Bytewerk/feuchtwerk/export/v1.0/feuchtwerk.jpg

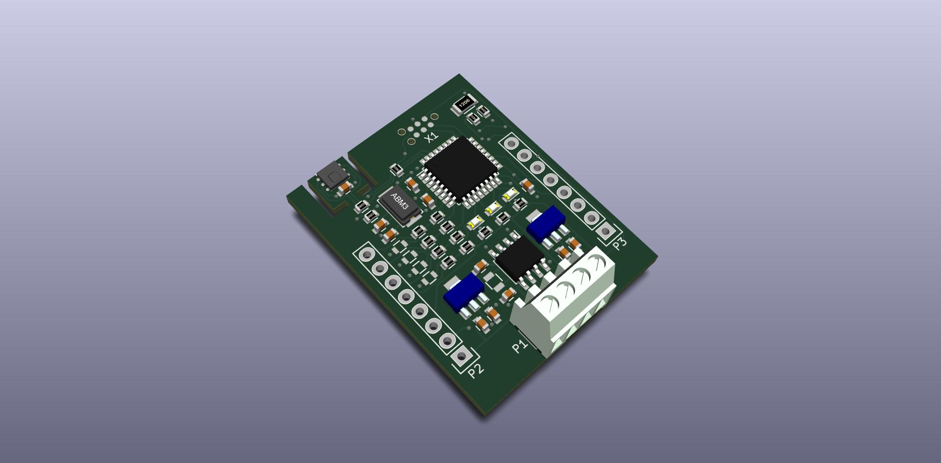
export/v1.0/feuchtwerk.jpg
