Bytewerk/feuchtwerk/export/v1.0/bom.xls

Id | Designator | Package | Qty | Designation | Spec | Manufacturer | MPN | Link
1 | C1,C4,C5,C6,C9,C12 | C_0603 | 6 | 100nF | MLCC/0.1uF/10V | Murata | GRM188R71E104KA01D | http://www.mouser.de/ProductDetail/Murata-Electronics/GRM188R71E104KA01D
2 | C2,C3 | C_0603 | 2 | 18pF | MLCC/18pF/10V | Vishay | VJ0603A180FXACW1BC | http://www.mouser.de/ProductDetail/Vishay-Vitramon/VJ0603A180FXACW1BC
3 | C7,C8,C10,C11 | C_0603 | 4 | 1uF | MLCC/1uF/25V | Murata | GRM188R61E105KA12D | http://www.mouser.de/ProductDetail/Murata-Electronics/GRM188R61E105KA12D
4 | D1 | LED_0603 | 3 | LED | red, any | Kingbright | APT1608EC | http://www.mouser.de/ProductDetail/Kingbright/APT1608EC
5 | D2 | LED_0603 | 3 | LED | yellow, any | Kingbright | APT1608YC | http://www.mouser.de/ProductDetail/Kingbright/APT1608YC
6 | D3 | LED_0603 | 3 | LED | green, any | Kingbright | APT1608SGC | http://www.mouser.de/ProductDetail/Kingbright/APT1608SGC
7 | P1 | Pin_Header_Straight_1x04 | 1 | CONN_01X04 | exact | TE Connectivity | 1546215-4 | http://www.mouser.de/ProductDetail/TE-Connectivity/1546215-4
8 | P2,P3 | Pin_Header_Straight_1x08 | 2 | CONN_01X08 | any | Würth Electronics | 61300811121 | http://www.mouser.de/ProductDetail/Wurth-Electronics/61300811121
9 | R1 | R_1206 | 1 | SFH3710 | exact | Osram | SFH 3710-3/4-Z | http://www.mouser.de/ProductDetail/OSRAM-Opto-Semiconductors/SFH-3710-3-4-Z
10 | R7,R10,R13,R18 | R_0603 | 4 | 100R | 100R/5% | Yageo | RC0603FR-07100RL | http://www.mouser.de/ProductDetail/Yageo/RC0603FR-07100RL
11 | R20,R21,R22 | R_0603 | 3 | 1K | 1K/5% | Yageo | RC0603FR-071KL | http://www.mouser.de/ProductDetail/Yageo/RC0603FR-071KL
12 | R14,R17 | R_0603 | 2 | 4K7 | 4K7/5% | Yageo | RC0603FR-074K7L | http://www.mouser.de/ProductDetail/Yageo/RC0603FR-074K7L
13 | R2,R5,R8,R11,R15 | R_0603 | 5 | 10K | 10K/5% | Yageo | RC0603FR-0710KL | http://www.mouser.de/ProductDetail/Yageo/RC0603FR-0710KL
14 | R3,R4 | R_0603 | 2 | 220K | 220K/1% | Yageo | RC0603FR-07220KL | http://www.mouser.de/ProductDetail/Yageo/RC0603FR-07220KL
15 | U1 | LQFP-32_7x7mm_Pitch0.8mm | 1 | STM32F042K6Tx | exact | STMicroelectronics | STM32F042K6T7 | http://www.mouser.de/ProductDetail/STMicroelectronics/STM32F042K6T7
16 | U2 | S-PWSON-N6 | 1 | HDC1080 | exact | TI | HDC1080DMBT | http://www.mouser.de/ProductDetail/Texas-Instruments/HDC1080DMBT
17 | U3 | SOT89-3_Housing | 1 | MCP1754ST-3302E/MB | exact | Microchip | MCP1754ST-3302E/MB | http://www.mouser.de/ProductDetail/Microchip/MCP1754ST-3302E-MB
18 | U4 | SOT89-3_Housing | 1 | MCP1754ST-5002E/MB | exact | Microchip | MCP1754ST-5002E/MB | http://www.mouser.de/ProductDetail/Microchip/MCP1754ST-5002E-MB
19 | U5 | SOIC-8_3.9x4.9mm_Pitch1.27mm | 1 | TJA1051/3 | exact | NXP | TJA1051T/3/1J | http://www.mouser.de/ProductDetail/NXP/TJA1051T-3-1J
20 | Y1 | ABM3 | 1 | 8MHz | exact | ABRACON | ABM3-8.000MHz-D2Y-T | http://www.mouser.de/ProductDetail/ABRACON/ABM3-8000MHz-D2Y-T
