Bytewerk/feuchtwerk/export/v1.0/feuchtwerk_schematic.pdf

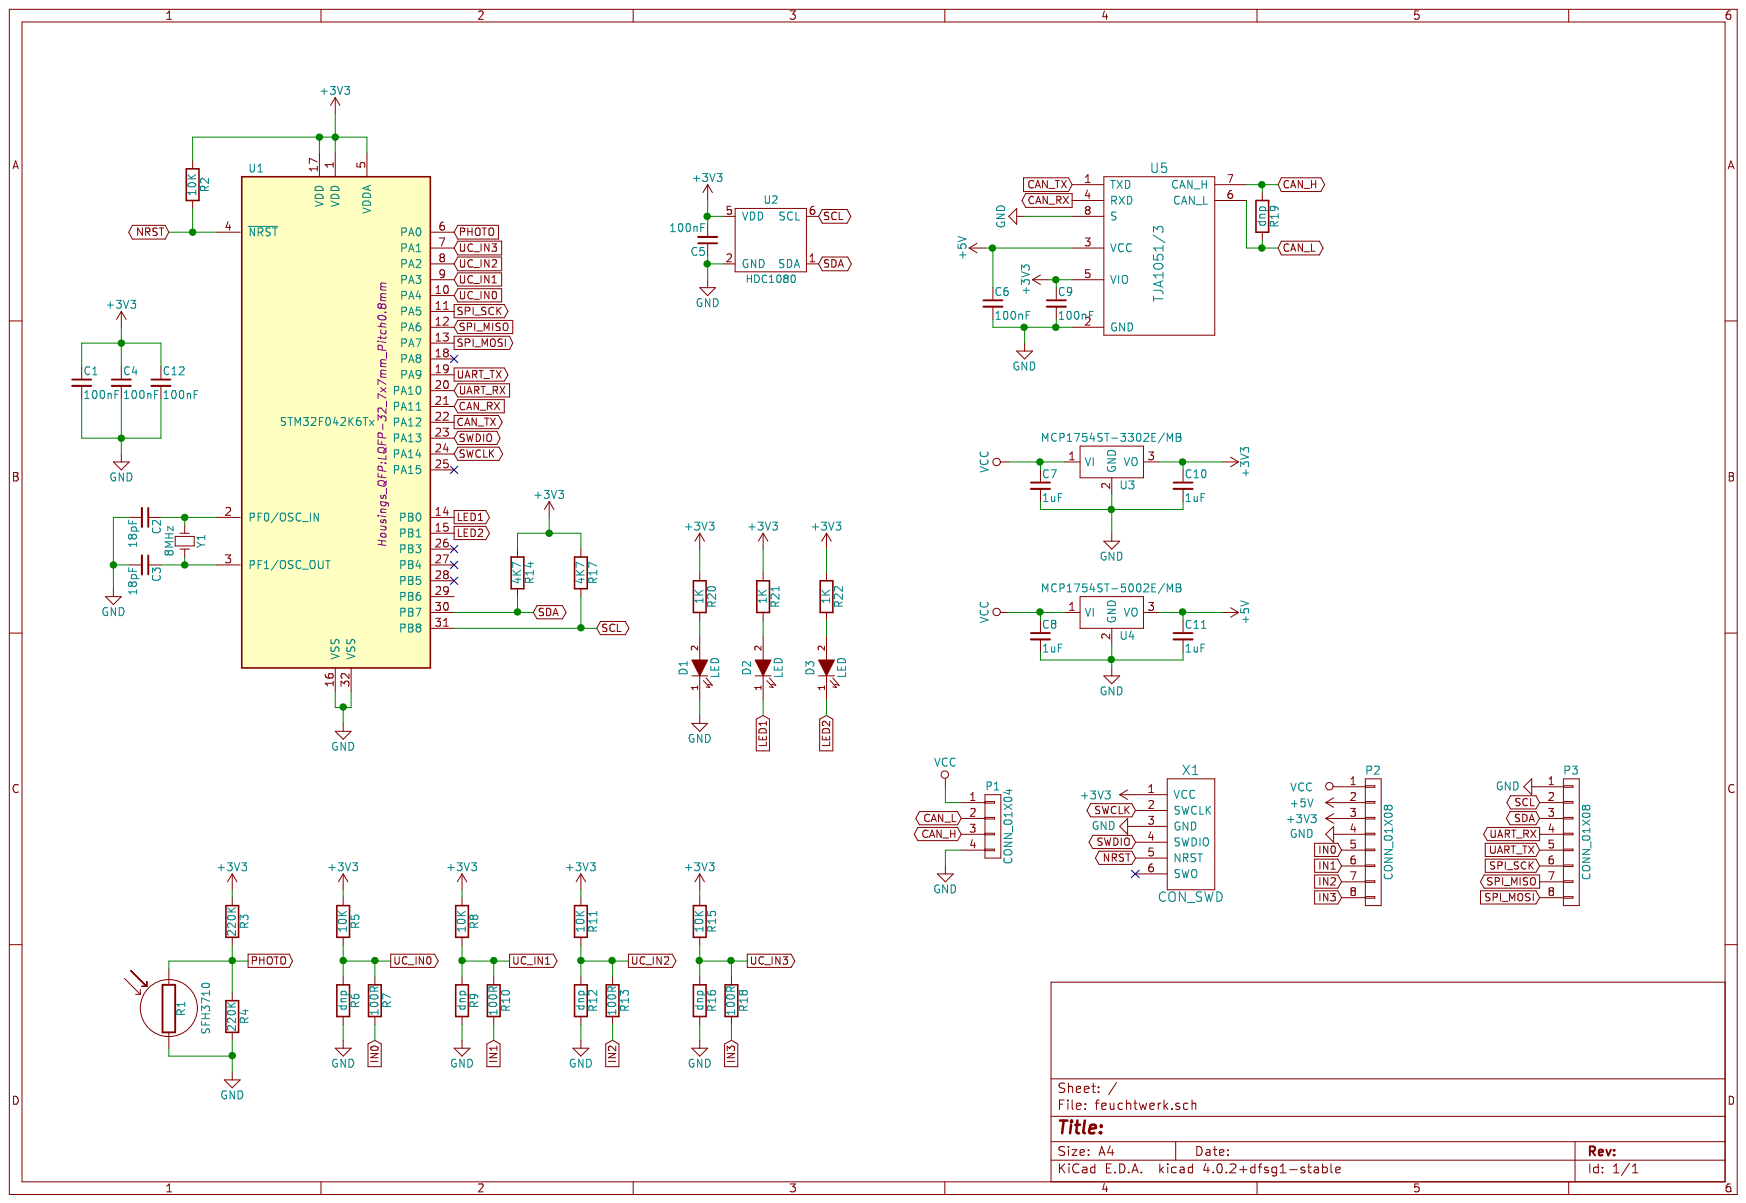
[picture p2: page 1]
