Bytewerk/feuchtwerk/feuchtwerk.kicad_pcb

## KiCad design feuchtwerk.kicad_pcb (2016-06-14)

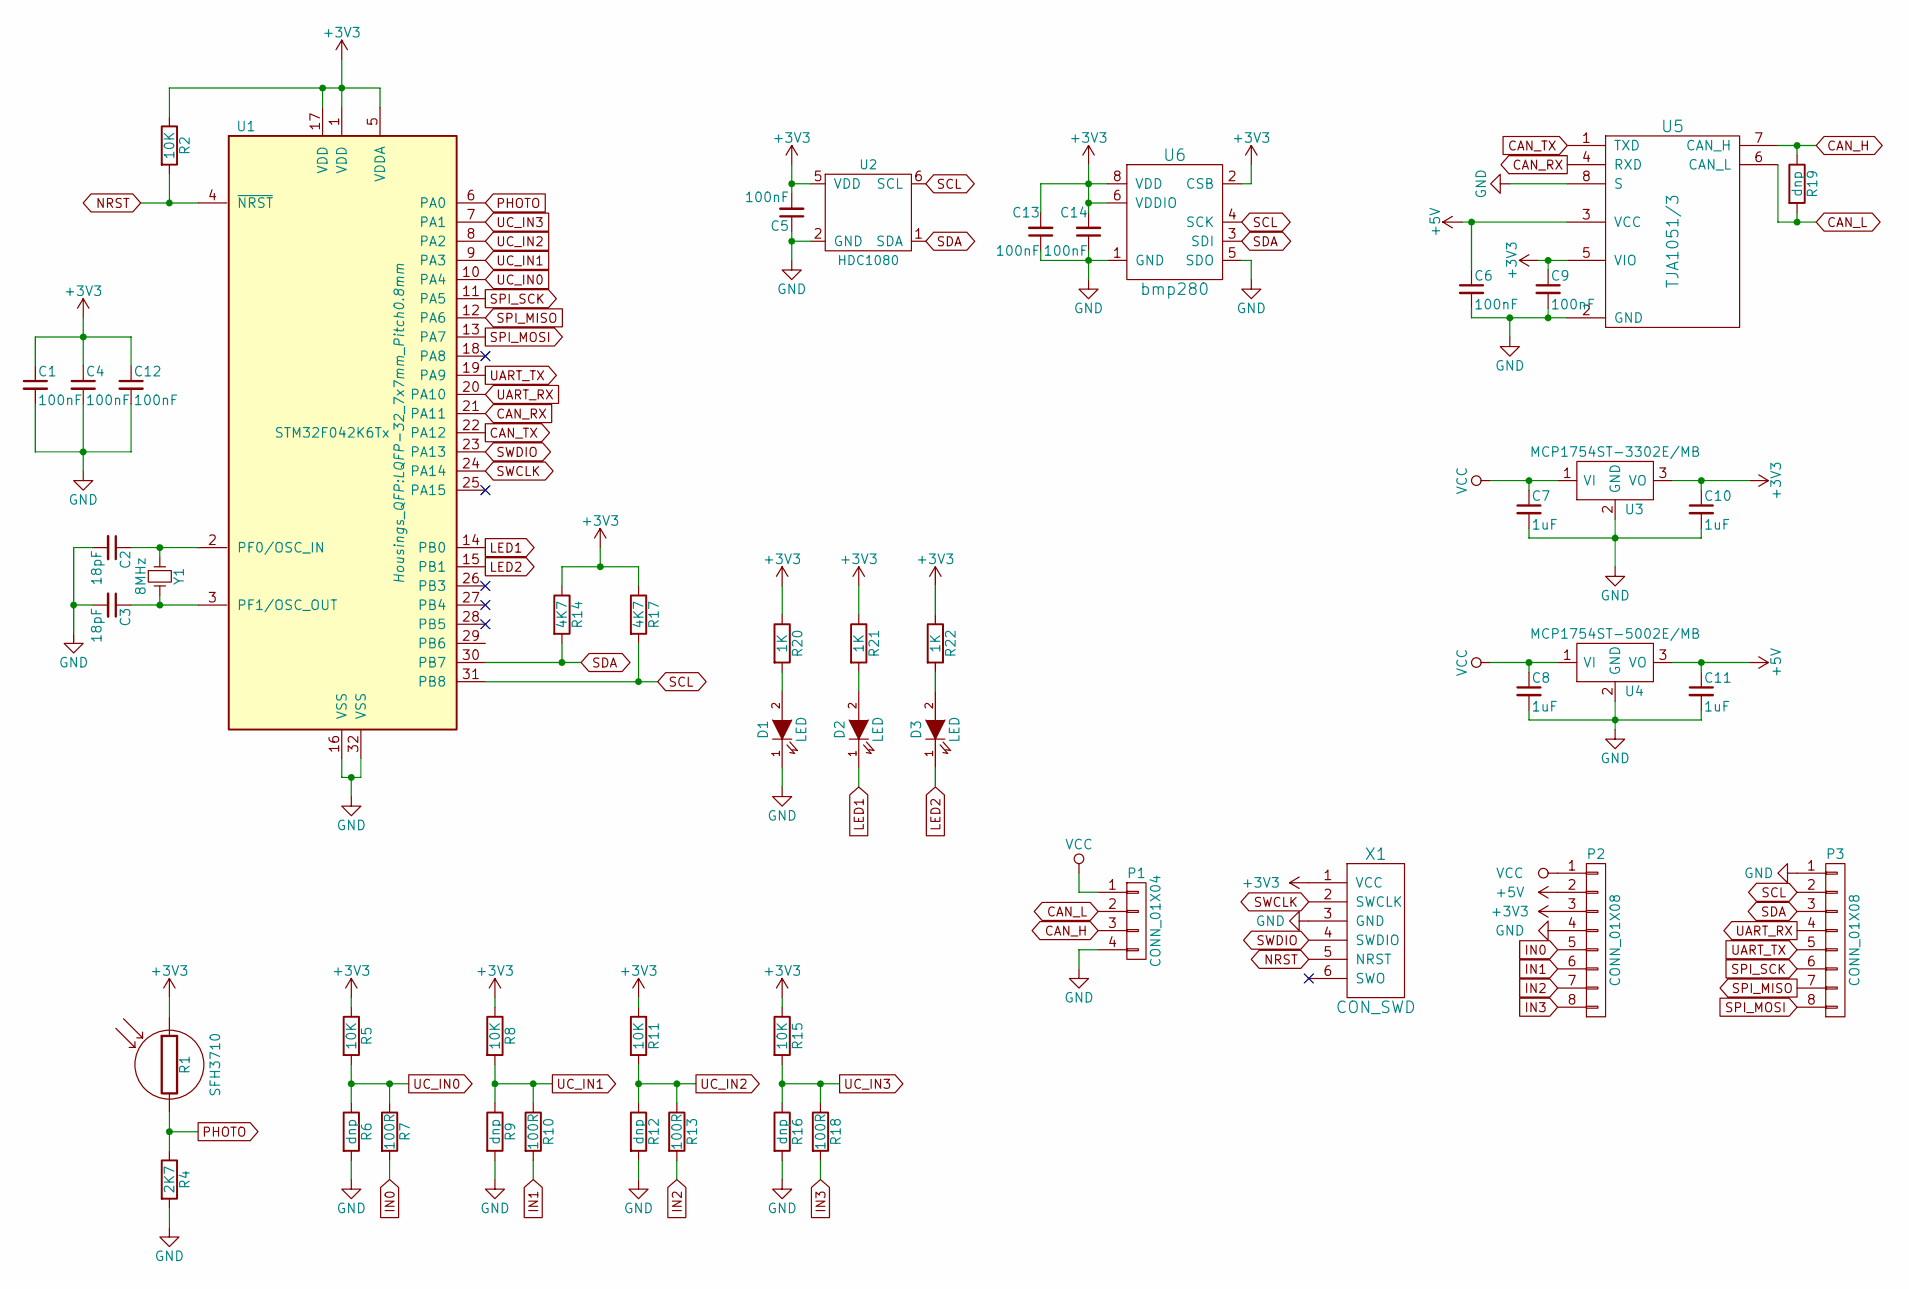
[picture p3: schematic feuchtwerk.sch]

Parts:
C1, C4, C5, C6, C9, C12, C13, C14: 100nF; C_0603
C2, C3: 18pF; C_0603
C7, C8, C10, C11: 1uF; C_0603
D1, D2, D3: LED; LED_0603
P1: CONN_01X04; Pin_Header_Straight_1x04
P2, P3: CONN_01X08; Pin_Header_Straight_1x08
R1: SFH3710; R_1206
R2, R5, R8, R11, R15: 10K; R_0603
R4: 2K7; R_0603
R6, R9, R12, R16: dnp; R_0603
R7, R10, R13, R18: 100R; R_0603
R14, R17: 4K7; R_0603
R19: dnp; R_0805
R20, R21, R22: 1K; R_0603
U1: STM32F042K6Tx; LQFP-32_7x7mm_Pitch0.8mm
U2: HDC1080; TEXAS-S-PWSON-N6
U3: MCP1754ST-3302E/MB; SOT89-3_Housing
U4: MCP1754ST-5002E/MB; SOT89-3_Housing
U5: TJA1051/3; SOIC-8_3.9x4.9mm_Pitch1.27mm
U6: bmp280
X1: CON_SWD; TC2030-NL
Y1: 8MHz; ABM3

Connections:
+3V3: C1.1, C4.1, C5.2, C9.1, C10.1, C12.1, C13.2, C14.2, P2.3, R1.1, R2.1, R5.1, R8.1, R11.1, R14.1, R15.1, R17.1, R20.1, R21.1, R22.1, U1.1 (VDD), U1.5 (VDDA), U1.17 (VDD), U2.5 (VDD), U3.3 (VO), U5.5 (VIO), U6.2 (CSB), U6.6 (VDDIO), U6.8 (VDD), X1.1 (VCC)
+5V: C6.1, C11.1, P2.2, U4.3 (VO), U5.3 (VCC)
CAN_H: P1.3, R19.1, U5.7 (CAN_H)
CAN_L: P1.2, R19.2, U5.6 (CAN_L)
CAN_RX: U1.21 (PA11), U5.4 (RXD)
CAN_TX: U1.22 (PA12), U5.1 (TXD)
GND: C1.2, C2.2, C3.2, C4.2, C5.1, C6.2, C7.2, C8.2, C9.2, C10.2, C11.2, C12.2, C13.1, C14.1, D1.1 (K), P1.4, P2.4, P3.1, R4.2, R6.2, R9.2, R12.2, R16.2, U1.16 (VSS), U1.32 (VSS), U2.2 (GND), U3.2 (GND), U4.2 (GND), U5.2 (GND), U5.8 (S), U6.1 (GND), U6.5 (SDO), U6.7 (GND), X1.3 (GND)
IN0: P2.5, R7.2
IN1: P2.6, R10.2
IN2: P2.7, R13.2
IN3: P2.8, R18.2
LED1: D2.1 (K), U1.14 (PB0)
LED2: D3.1 (K), U1.15 (PB1)
NRST: R2.2, U1.4 (~NRST), X1.5 (NRST)
unnamed: C2.1, U1.2 (PF0/OSC_IN), Y1.1
unnamed: C3.1, U1.3 (PF1/OSC_OUT), Y1.2
unnamed: D1.2 (A), R20.2
unnamed: D2.2 (A), R21.2
unnamed: D3.2 (A), R22.2
PHOTO: R1.2, R4.1, U1.6 (PA0)
SCL: P3.2, R17.2, U1.31 (PB8), U2.6 (SCL), U6.4 (SCK)
SDA: P3.3, R14.2, U1.30 (PB7), U2.1 (SDA), U6.3 (SDI)
SPI_MISO: P3.7, U1.12 (PA6)
SPI_MOSI: P3.8, U1.13 (PA7)
SPI_SCK: P3.6, U1.11 (PA5)
SWCLK: U1.24 (PA14), X1.2 (SWCLK)
SWDIO: U1.23 (PA13), X1.4 (SWDIO)
UART_RX: P3.4, U1.20 (PA10)
UART_TX: P3.5, U1.19 (PA9)
UC_IN0: R5.2, R6.1, R7.1, U1.10 (PA4)
UC_IN1: R8.2, R9.1, R10.1, U1.9 (PA3)
UC_IN2: R11.2, R12.1, R13.1, U1.8 (PA2)
UC_IN3: R15.2, R16.1, R18.1, U1.7 (PA1)
VCC: C7.1, C8.1, P1.1, P2.1, U3.1 (VI), U4.1 (VI)

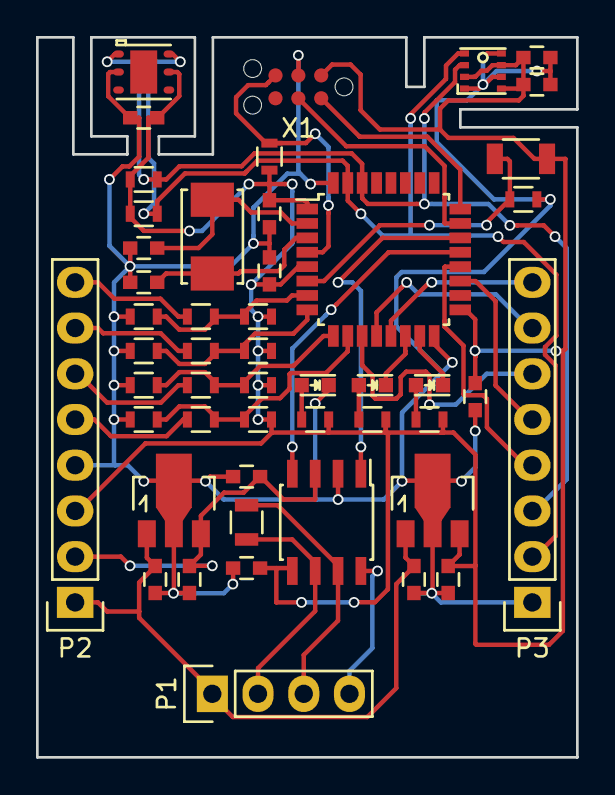
[picture p4: board feuchtwerk.kicad_pcb from above]

Board: 2 copper layers, 30.0 x 40.0 mm, 49 parts (0 on the bottom side), 34 nets.
