Bytewerk/feuchtwerk/(commit log)

2016-06-04 initial checkin
    [feuchtwerk.kicad_pcb, feuchtwerk.sch]
2016-06-05 change board dimensions, milling slot for humidity sensor
    [feuchtwerk.kicad_pcb]
2016-06-05 add clearance around tagconnect drills
    [feuchtwerk.kicad_pcb]
2016-06-05 add fiducials
    [feuchtwerk.kicad_pcb]
2016-06-05 gerber export for fusionpcb
    [feuchtwerk.kicad_pcb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]
2016-06-14 add exports
    [bom.xls]
2016-06-14 fix wrong light transistor setup, add bmp280 air pressure sensor
    [feuchtwerk.kicad_pcb, feuchtwerk.sch]
2016-10-01 modified HDC1080 symbol; changed pin6 (SCL) type from power to bidirectional
